sasahara-h/tee-echo-sim/docs/handoff-route1-sensor-nav.md

# 引き継ぎメモ：ルート1（センサーで実物の操作をシミュレータに入れる）以降

作成：2026-10-14　更新：2026-10-15（エンコーダを PEC11D-4120F-S0015 に決定、`.scad` を v2 に改訂）

---

## 1. いまの到達点（作り直さないこと）

- `claude/index.html`（Claude Code で作成済み・手元は `c:/dev/tee-sim`）
  - GPUクリッピング＋Render-to-Texture で断面描画。CPUボクセル方式は廃止済み
  - プローブ4自由度＋左右屈（depth / rot / ante / lr / omni）、標準断面プリセット15種
  - **練習モード＝ナビはすでに実装済み**：一致度メーター（85点で合格）、「次の一手」（例：時計回りに15°回す）、チェックリスト、ASE/SCA 2013・Puchalski 2019 準拠のコース
  - 外部から操作できる窓口がある：`window.TEESIM.setParam(k, v)`（k = depth, rot, ante, lr, omni）、`window.TEESIM.state`
- `claude/hardware/tee_handle.scad`：模型ハンドルの設計図 **v2（PEC11D 対応）**。STLは未書き出し。OpenSCAD で PART を切り替えて F6 → 書き出す

## 2. 先行品の調査結果と立ち位置

- 実物型プローブ付きの商用機：HeartWorks TEE、BabyWorks TEE（新生児・乳児、ASD/VSD等）、CAE Vimedix、MrTEEmothy/eTEEmothy
- Web型：トロント Virtual TEE（標準20断面＋代替19断面、録画動画。自由操作ではない）、CT2TEE（CTベース、自由操作、先天性心疾患2例）、iPhoneアプリ TEE Simulator
- 誘導機能も既存品にある（HeartWorks、TEE Express）。**「シミュレータ単体」「シミュレータ内の誘導」に新規性はない**
- 差別化の候補：
  1. **自前の数理モデルを外部センサー・外部端末とつなげること**（既製品は閉じていて中身を使えない）
  2. 小児の体格・先天性心疾患（特に複雑心奇形、術後形態）
  3. スマートグラスでの術者視界ガイド
- 指導医へは「TEEシミュレータを作った」ではなく、「断面ナビの研究基盤」として、動いている録画を添えて見せる方針

## 3. 実機ガイドへの3ルート

| ルート | 内容 | 必要データ |
|---|---|---|
| **1（いまここ）** | センサーでプローブ状態を直接測り、シミュレータのモデルで目標との差分を計算 | ほぼ不要 |
| 2 | 画像から「今どの標準断面か」だけを分類し、ルート1のずれを補正 | 中程度 |
| 3 | 画像からプローブ位置を推定（シミュレータを教師データ工場に） | 大量。個人では保留 |

カーナビの比喩：センサー＝GPS、シミュレータの心臓モデル＝地図、練習モードの「次の一手」＝「300m先を右」。

### ルート1の弱点（先に言っておくこと）
- 地図（標準モデル）が患者に合っていない → 方向の誘導は使えても「あと15°」の数字は外れうる。最終微調整は術者が画像で
- ダイヤル角＝先端の曲がりとは限らない（食道壁で拘束、シャフトのねじれ）
- 臨床プローブへの取り付けは感染管理・倫理委員会・医療機器の扱いが壁 → **まずはマネキン／模型ハンドルで**

## 4. ハードウェア計画（模型ハンドル）

### 部品
| 物品 | 用途 |
|---|---|
| 二重同軸ロータリーエンコーダ **Bourns PEC11D-4120F-S0015（決定）**、DigiKey 約1,150円。予備含め2個 | 外側＝大ダイヤル（前屈/後屈）、内側＝小ダイヤル（左右屈）。TEEの2連ダイヤルと同じ構造 |
| ユニバーサル基板（2.54mmピッチ、20×33mm に切る） | エンコーダを半田付けし、ハンドル内の柱2本にネジ留め |
| M5StickC Plus2 | マイコン。内蔵IMUで主軸回転も測る（ドリフトが気になれば BNO085 を追加） |
| タクトスイッチ 12mm ×2 | オムニプレーン ＋/− |
| M3タッピングネジ ×4（本体結合）＋ ×2（基板）＋ M3イモネジ ×2（ダイヤル固定） | |
| USB-Cケーブル | PC接続・給電（底の穴から出す） |

挿入深度は当面手入力（シャフト目盛り）。磁気角度センサー AS5600 方式は、同軸エンコーダを使うなら不要。
本物の廃棄プローブは院内（臨床工学技士・メーカー営業）で探す。eBay等の個人購入は薬機法・感染リスクの点で非推奨。

### PEC11D について確定したこと（データシート https://www.bourns.com/data/global/pdfs/PEC11D.pdf ）
- **S（ストローク0.5mm）を選んだ理由**：H（1.5mm）だと、ダイヤルを回す指の力で軸が沈み、ゼロ点リセットの誤作動とダイヤルのぐらつきが増える。プッシュは「長押しでゼロ点」にしてファーム側でも誤作動を防ぐ
- **取付金具なし（Hardware: None）、ブッシュ φ7.0 はネジ山なし** → ナット留めはできない。固定は「壁穴にブッシュ」「受け台で回り止め」「小基板を柱にネジ留め」の3点で行う
- 外軸 φ6.0（スリット入り）、ブッシュ φ7.0、本体 12.0角、軸長は取付面から 20.0
- 30クリック/回転、15パルス/回転 → **1クリック＝ダイヤル12°**。4逓倍で数えると60カウント/回転
- 回転トルク 100±70 gf·cm（φ64ダイヤルなら指先で約30gf＝軽い）、軸の横荷重 2.04kgf以上、回転寿命15,000回
- 実物のTEEダイヤルは滑らか、PEC11Dはクリック感あり（試作では許容）

### クリックの刻みの検証（2026-10-15）
- `index.html` に検証用の「クリック刻みモード」を追加済み（コミット d6a2916。「微調整スライダー・表示設定」の一番下）
- 前屈/後屈の刻みを 28 → 14 → 9° と変えて触った結論：**先端の角度で1クリック14°以下でないと練習にならない**
- 前屈/後屈の全範囲は210°（−90〜120）なので、14°以下にするには**15クリック以上＝ダイヤルが止めから止めまで180°以上回る**必要がある
- 判断基準：大学で実物のダイヤルの回転角を測り、**180°以上なら PEC11D で実物どおりの回転角にできる**。180°未満なら、ダイヤルを実物より多く回す設定にする（録画用には十分）か、2号機を磁気センサー（AS5600 など）にする
- 測るもの：大小ダイヤルの止めから止めまでの角度、ダイヤル90°で先端がどれだけ曲がるか、ダイヤル径、オムニプレーンボタンの動き方、ロックレバー。真上からの動画があると確実

### `.scad` v2 の変更点
- エンコーダ部分だけ壁を 2.0mm に薄くし、φ7.3 のブッシュ穴（取付ネジ前提の φ9.5 を廃止）
- 右半分の内側に **受け台**（12.3角の四角い筒、深さ5mm）と **基板止めの柱2本**（軸から上下12.5mm、M3下穴）を追加
- ダイヤルの厚みと軸穴の深さを、軸長パラメータから自動計算（外軸のかかり 6.2mm、内軸のかかり 7.7mm：仮の値で）
- 小ダイヤルは Dカット穴、止めネジは平面側
- ボタン穴を前面の壁だけに限定（内側の柱・受け台を削らないように）
- **`PART = "fit_test"`** を追加：ブッシュ穴・外軸穴・内軸Dカット穴を余裕 0.1〜0.4mm で並べた試験片。プリンタのクセを先に確かめる
- 組立図に赤い簡易エンコーダと小基板を表示。F5 のコンソールに寸法と警告を echo
- 数値チェック済み：本体背面 X=7.0、基板裏 X=5.4、端子先端 X≈1.9（分割面 X=0 より右＝右半分に全部収まる）。受け台・柱・ボタン穴・ネジボスは互いに非干渉
- **OpenSCAD での描画確認はまだ**（作業環境にインストールできなかった）。手元で F5 → 赤い警告が出ないことを確認

### 実物が届いたらノギスで測る（`.scad` の ★ を上書き）
1. **内軸の直径と、Dカット部の寸法**（INNER_SHAFT_D / INNER_D_ACROSS）：データシートの読み取りで φ3.5・2.5 としたが最も不確か
2. **外軸の先端までの長さ**（OUTER_SHAFT_END）：取付面から。候補 10.0 / 11.7 / 13.1
3. 本体の奥行き（ENC_BODY_DEPTH、仮 8.0）とブッシュ長（BUSH_LEN、仮 5.0）
4. 端子が背面から出る長さ（基板の厚みと合わせて分割面を越えないか）

## 4b. 方針変更（2026-10-16）：滑らかなダイヤル＝ポテンショメータ＋歯車方式で行く

PEC11D（クリック式）は**保留（購入しない）**。理由：滑らかさ・回しきりの止め・電源投入時に角度が分かること・1°未満の細かさ・マイコンのピン不足の解消を優先。

### 構造
- 同軸の軸：入れ子になる真鍮パイプ（外側＝外径6mm、内側＝外径5mmのパイプか丸棒。K&S のメートル系真鍮パイプは肉厚0.45mmで入れ子になる設計）。外側に大ダイヤル（前屈/後屈）、内側に小ダイヤル（左右屈）
- 各軸に3Dプリントの歯車 → ハンドル内に横並びの**クリックなしポテンショメータ（B10KΩ＝直線、約300°で止め付き）2個**を回す。同軸の問題は歯車で横にずらして解決
- 軸受けは当面プリントのブッシュ。Oリングで回転に適度な重さ（手を離しても止まる）
- 歯車比は、大学で測る実物ダイヤルの回転角で決める（実物の全回転角 → ポテンショメータの約300°の内側に収める）
- M5StickC Plus2 のピン：ポテンショメータは ADC1 の G32・G33（Grove 端子）、ボタンは G26・G36 など。ゼロ点合わせは不要（絶対角）。両端に回しきったときの値を一度記録するキャリブレーションだけ

### 次の作業
1. ポテンショメータ数種と真鍮パイプを買って、手で回した感触と入れ子のはまり具合を確かめる
2. 実物の寸法（ポテンショメータの本体径・軸径・軸長・取付ネジ、パイプの実寸）を測る
3. `.scad` v3 を作る：同軸シャフトの軸受け、歯車2組、ポテンショメータの取付台（M7ナットで留める）、ボタン位置の見直し

### 購入状況（2026-10-17 注文）
- 秋月：小型ボリューム 10KΩB（118292）×4、ユニバーサル基板 Cタイプ ×2、タクトスイッチ 12mm 黒・グレー 各2、コネクター付ケーブル 40P オスメス、みの虫クリップ付きコード ×2、ピンヘッダ 1×40
- Amazon：M5StickC PLUS2、USB A–C ケーブル 1m×2、タッピングねじ 3×8（2種 B0形）、イモネジ M3×3、TONE 六角レンチ 1.5mm ×2、Oリング（benrii 18種）、M3 六角ナット（5.5×2.4）、K&S アルミパイプ 外径6/内径5.1（KS9805）、K&S 真鍮パイプ 外径5/内径4.1、WORKPRO パイプカッター、ステンレス デジタルノギス
- 半田ごては保留（ものづくり施設で借りられるか確認中）。PEC11D は買わない

### `.scad` v3 試作ブロック（`claude/hardware/tee_handle_v3_testblock.scad`、下書き）
- ダイヤル・同軸パイプ・歯車・ボリューム2個だけの手のひらサイズ。枠（前板＋筒、ボリューム板A/B、側板）
- ボリュームAは軸の上（+Z、中心距離16.15）、Bは下（-Z、14.15）。どちらも本体が奥、軸先が前板を向く。軸先に小歯車を圧入
- 歯車 m=1、A 16:16、B 14:14（比率1）。歯車A/Bはパイプに圧入、ダイヤルは M3 ナット埋め込み＋イモネジ
- 大ダイヤルの重さは前板の溝の Oリング（5×2）で調整
- パイプを切る長さ（初期値）：外側23.8mm、内側39.6mm。前板外面からボリュームB背面まで43.1mm → ハンドル組込み時は頭部を広げるか、ボリュームの軸を切って短くする
- 寸法の干渉チェックは Python で全項目 OK。OpenSCAD での描画確認はまだ（作業環境に入らない）
- ★の仮の値：ボリュームの本体厚・ネジ部の径と長さ・軸長・ナット寸法、歯車の圧入値、実物ダイヤルの回転角

### ファームウェアの準備（2026-10-17）
- `firmware/`（PlatformIO、Arduino、M5Unified 0.2.26 / M5GFX 0.2.33 / espressif32 7.1.3 に固定、env名 m5stickc_plus2）。画面に「Hello」を出すだけの最小版。ビルド SUCCESS、コミット済み（4872439）
- VS Code に PlatformIO IDE 拡張を導入済み。`firmware` フォルダを開くと下のバーに ✓（ビルド）→（書き込み）コンセント（シリアルモニター）が出る
- 今の main.cpp は PC に何も送らない（シリアルモニターは空のまま。画面に Hello が出れば成功）
- 実機が届いたら → で書き込み。ポートが見つからなければ CH9102 ドライバ
- fit_test の STL は書き出し済み（hardware/ に tee_handle_v3_testblock.stl として保存。PART が fit_test だったか要確認、fit_test.stl に改名予定）

### 実機TEEダイヤルの実測（2026-10-20、大学、**Philips X8-2t**（xMATRIX 成人用 3D TEE）。写真から読み取り、誤差 ±10°程度）
- 大ダイヤル（前屈/後屈、奥・薄い灰色・羽根6枚）：まっすぐ＝目印9時。**前屈いっぱい 約95°（時計回り）／後屈いっぱい 約60°（反時計回り）／全体 約155°**。まっすぐの位置は前屈側に寄っている（非対称）
- 小ダイヤル（左右屈、手前・濃い灰色）：まっすぐ＝9時（ダイヤルに細い線の目印あり）。**右屈 約50°／左屈 約55°／全体 約105°**、ほぼ対称
- まっすぐのとき大小とも9時方向がそろう作り。小ダイヤル表面に R/L の矢印印刷（矢印の先の印は止めの位置ではない）
- オムニプレーンのボタン：ダイヤルが出ている面から90°回った面（ダイヤルとほぼ同じ高さ）に、縦長の黒いゴムのパネル。**丸ボタン（上）・楕円ボタン（中）・丸ボタン（下）の3つ**。上下が ＋/−。**中央の楕円は押せない（ボタンではない。指で上下を区別する目印と思われる）**。模型でも中央に押せない出っ張りを付けると手触りが近づく。v2 の配置（ダイヤル＝+X 側面、ボタン＝前面）と同じ関係
- ダイヤル直下にレバー（ロックレバーと思われる）
- 設計への反映：DIAL_TRAVEL_A=155、DIAL_TRAVEL_B=105。歯車比はボリューム300°の内側に収まるよう上げる（A 約1.7、B 約2.5 が目安）。ダイヤルに機械的な止めを付けて、実物と同じ回転角で止まるようにする

### 持ち方（2026-10-21 ユーザー提示、こちらが正。先に見せた成書の図は古い情報として破棄）
- 左手で操作部、右手でシャフトの両手操作が標準。観察中は持ち替えない
- 左手：**親指＝大ダイヤル（前屈/後屈）**、**人差し指・中指＝小ダイヤル（左右屈）**、**薬指・小指＝グリップを握って支える**、空いた指でロックレバー・オムニプレーンのボタン等
- 右手：口元近くでシャフトを持ち、**挿入・引き抜き**と**シャフトをひねる主軸回転**
- **実際の臨床（ユーザーの経験）**：指の担当は固定ではなく、大ダイヤル・小ダイヤル・オムニボタンを**親指・人差し指・中指のうち空いている指で**操作している。薬指・小指は握って支える
- 設計への反映：
  - **最重要：大ダイヤル・小ダイヤル・オムニボタンの3つすべてが、握ったまま親指・人差し指・中指のどれからも届く範囲にまとまっていること**（指の担当を決め打ちしない）
  - グリップは薬指・小指で支えられる太さ・長さ。持ち替え不要な配置
  - 大ダイヤルは親指が自然に掛かる位置、小ダイヤルは人差し指・中指が届く位置（実機は同軸で小が手前）
  - 主軸回転は右手でシャフトをひねる → ハンドルも一緒に回るので、ハンドル内 IMU で測る方針は変わらない
  - 挿入深度も右手がシャフトで行う → 模型にもシャフト（チューブ）を付ける価値が高い。深度センサーを足すときはシャフト側（糸巻き式など）
- **口とシャフトはコントローラー完成後に作る**（順番：試作ブロック → ハンドル本体 → シミュレータ連動 → 録画 → 口とシャフト）。そのための今からの準備：
  - ハンドル本体の先端側に、シャフト（チューブ）を差し込む穴を最初から設ける（大きめにして、チューブ決定後に変換部品で合わせる）
  - M5StickC Plus2 の ADC1 ピン3本（G32・G33・G36）のうち、G32・G33 をダイヤル2つ、**G36 を挿入深度用に予約**
  - 口の部品（シャフトが通る筒、机に固定、深度センサーをここに付ける）は別部品なのでいつでも作れる

### 挿入深度・主軸回転（あとで考える）
- 挿入深度は当面センサーなし（シミュレータのスライダー／キー）。後で足すなら、予備のボリュームに糸巻きを付けてシャフトに糸を結ぶ方式が最も手軽。ほかに距離センサー
- 主軸回転は M5StickC 内蔵 IMU（MPU6886、地磁気なし）のジャイロ頼み → ドリフトする。ボタンでゼロ点合わせ、気になれば BNO085 を追加

## 5. 次にやること（順番）※1番は 4b の方式に置き換え

1. ~~エンコーダの選定~~（済：PEC11D-4120F-S0015）／~~.scad の PEC11D 対応~~（済：v2、仮寸法）
   → **残り**：購入 → 実寸を測って ★ を上書き → fit_test を印刷して余裕を決定 → 右半分・ダイヤルを書き出し → 3Dプリント（院内・大学・自治体のものづくり施設）
2. M5StickC Plus2 のファームウェア（Arduino）：エンコーダ2軸のカウント（4逓倍）、ボタン2つ＋軸プッシュ（長押しでゼロ点）、IMUのヨー角を読み、一定周期でシリアル送信
3. `index.html` に **Web Serial** 入力を追加し、受け取った値を `TEESIM.setParam` に流す
   - ゼロ点合わせ（キャリブレーション）ボタン、カウント→角度の換算係数を設定可能に（初期値：1クリック＝12° のダイヤル回転に対し、先端角を何度とみなすか）
   - 既存の範囲：ante −90〜120、lr −45〜45、rot −180〜180、omni 0〜180
4. 実物のダイヤルを回すと断面と練習モードのナビが連動する様子を録画 → 指導医へ
5. 練習モードの「次の一手」を別端末（スマホ → Even G2 スマートグラス）に表示
6. 小児サイズ：まず相似縮小（角度は不変、挿入深度だけ縮む）。小児らしい形態は ImageCHD / HVSMR-2.0 / NIH 3D Print Exchange のモデルが必要（弁なし・食道位置・座標系統一・ライセンスに注意）
