sasahara-h/tee-echo-sim/(commit log)

2026-10-13 TEEプリセットに4断面を追加（MV Comm, RV In-Out, AsAo LAX, TG 2Ch）
2026-10-13 大血管系に大動脈弓・胸部下行大動脈・左右肺動脈を追加
    - build_heart.py: FJ3411 (Arch), FJ1931 (DAo), FJ3019 (RPA), FJ2924 (LPA) を追加
    - bodyparts3d.js を再生成
    - index.html: classify() で新パーツを vessel として扱う
2026-10-13 食道経路を下行大動脈の右側に引き直し、AsAo SAX・Desc Ao SAX/LAX を追加（全13プリセット再計算）
2026-10-13 AsAo LAX・TG mid SAX・TG 2Ch をASEガイドラインの角度範囲に合わせて修正
2026-10-13 大動脈弁の左冠尖と無冠尖のFJ番号の対応を修正
    FMA の left posterior cusp (FJ2426) が左冠尖、right posterior cusp (FJ2431) が無冠尖。
    build_heart.py の対応を入れ替え、bodyparts3d.js を再生成。
2026-10-13 PV弁尖を主肺動脈起始部へ寄せる fixPV 補正を追加
2026-10-13 練習モードを追加（目標断面への操作ガイド・一致度判定・ヒント）
    - 目標断面（13プリセット or ランダム）を選んで開始、一致度 85 以上で合格
    - 深度・回転・オムニ角・前後屈・左右屈の順に次の一手を表示
    - ヒントに ASE/SCA 2013 準拠の操作のコツと見えるべき構造
    - 練習中はオーバーレイの近い標準断面表示を隠す
2026-10-13 練習モードをベース断面→派生のコース形式に変更、UE大動脈弓 LAX/SAX を追加
2026-10-13 CLAUDE.md を追加（目的・座標系・数値の扱い・作業ルール）
2026-10-13 source/ の生成ファイルを .gitignore に追加
2026-10-13 左パネルに BodyParts3D のクレジットと教育用の注意書きを追加
2026-10-13 クレジットを左パネル最下部の1行に簡略化し、教育用の注意書きを削除
2026-10-14 練習モードの手順を「今からの量＋目標の絶対値」に統一し、合格後は模範との差を参考表示に
2026-10-14 .gitignore に *.zip を追加
2026-10-15 検証用の「クリック刻みモード」を追加（ante/lr の手動操作を刻み幅の倍数に丸める）
    スライダー・キー・ホイール・大小ダイヤルのドラッグが対象。プリセットと練習モードの移動は丸めない。
2026-10-15 TEE プローブ模型ハンドルの OpenSCAD ファイルを追加、.gitignore に *.stl を追加
    [tee_handle.scad]
2026-10-17 TEE プローブ模型ハンドル v3 の試作ブロック（ボリューム＋歯車方式のダイヤル部）を追加
    [tee_handle_v3_testblock.scad]
2026-10-17 v3 試作ブロックに組立図の断面表示（CUTAWAY）を追加
    [tee_handle_v3_testblock.scad]
2026-10-17 M5StickC Plus2 用ファームウェアの最小プロジェクトを追加（PlatformIO、画面に Hello を表示）
2026-10-18 練習モードのパネルをエコー画面左上の半透明フローティングカードに移す
    - 未開始時は「練習モード ▶」の小ボタンのみ表示し、押すと断面選択つきカードを開く
    - カード幅はエコー画面幅の35%（200〜320px）、高さが足りないときはカード内スクロール
    - ヘッダーの「−」で畳むと「目標名＋次の一手」の1行だけになる
    - 背景・内側要素を半透明にして、扇形に重なってもエコー像が透けて見える
2026-10-18 3Dビューとエコー画面の幅を 4:6 にし、境目をドラッグで動かせるようにする
    - 初期比率は 4:6（保存はせず、開くたびに 4:6 に戻る）
    - 境目ドラッグで比率を変更（3D 側 20〜80% に制限）。狭い画面の縦並びレイアウトでは非表示
    - 3D ビューが狭くなっても見出しがボタンに重ならないよう省略表示にする
2026-10-18 練習カードの目標名の下を「断面の目的」1文に変える
    - PRACTICE_INFO に各断面の purpose を追加し、目標名の下に表示
    - 操作方法（how）はヒントの「操作のコツ」にだけ出す
2026-10-18 ME 4Ch のヒント「操作のコツ」から目的文と重複する一文を削る
2026-10-18 練習カードの置き場所を画面幅で切り替える
    - 980px以下（縦並びレイアウト）では左パネルの読み取り値の下に普通のパネルとして表示
    - 広い画面では従来どおりエコー左上のフローティング
    - 同じ DOM を移動するので、中身・ボタン・畳む状態は両方で共通
2026-10-18 スマホ表示を1画面レイアウトに戻し、Retina端末で断面が崩れるバグを直す
    - renderSection / renderEcho で RenderTarget 描画時の setViewport を削除
    （three.js が devicePixelRatio を掛けるため、DPR 2〜3 の端末で断面が拡大・欠落していた）
    - 980px以下：縦持ちは上段エコー／下段左3D・右ハンドル、横持ちは ハンドル｜エコー｜3D。ページはスクロールしない
    - ヘッダーはプリセット1行の横スクロール＋「⚙ 詳細」ボタン。読み取り値・設定・説明・クレジットを #panelExtra にまとめ、下からのシートで開閉
    - 練習カードはスマホでは詳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
2026-10-18 スマホをコントローラーにして PC と連動させる「連動モード」を追加
    - ヘッダー右端「📱 スマホで操作」で QR コードとコントローラー用 URL を表示（localhost のときは IP で開き直す案内）
    - 連動中の PC はハンドルパネルを隠して 3D＋エコーを全幅表示。「連動中 ●」「通常モードに戻す」
    切断（ハートビート 5 秒途絶）または戻すボタンで通常レイアウトへ。プローブ位置は引き継ぐ
    - スマホ側（?controller=部屋ID）はプリセット1行＋ハンドルだけ。3D・エコーは描画しない
    値の変化を最大30回/秒で送信、プリセッ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
2026-10-18 コントローラー画面（?controller=）でダイヤルが表示されないのを直す
    - 原因：グリッド列が 1fr だったため、横スクロールのプリセット列（約1570px）の幅まで広がり、
    SVG がその中央＝画面外にダイヤルを描いていた。列を minmax(0,1fr) にする
    - あわせて #handleSvg を #handlePanel に絶対配置して枠いっぱいに置く（flex 内の SVG に頼らない。iPhone Safari 対策）
2026-10-18 3Dビューに「ホログラム表示」モードを追加（表示設定のチェックボックス、初期値 OFF）
    - ON：心臓・血管とゴーストを加算合成のフレネル（リムライト）シェーダーに差し替え、背景を暗く
    水色〜シアン、弁は明るめ。横の細い走査線がゆっくり流れ、わずかにちらつき、明るさだけゆっくり脈打つ
    - OFF：元のマテリアル・背景オブジェクトに戻すので見た目は完全に元どおり
    - プローブ・扇は変更なし。2Dエコー（別シーンで描画）と練習モードには影響しない
    - 処理は「4d. ホログラム表示」ブロック（makeHoloMat /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
2026-10-18 スマホ表示のヘッダーに「📱 スマホで操作」が出てしまうのを直す
    非表示ルールが .linkUI の基本ルールより前にあって上書きされていた。基本ルールの後ろに移す
2026-10-18 PC のヘッダーを低くし、「📱 スマホで操作」をプリセットと同じ行に置く
    プリセット列が1行分の幅（約1570px）で場所を取り、ボタンが3行目に押し出されていた。
    プリセット列を flex:1 1 0 にしてタイトル・ボタンと同じ行で折り返すようにする（1528px 幅で 140px → 71px）
2026-10-18 Revert "PC のヘッダーを低くし、「📱 スマホで操作」をプリセットと同じ行に置く"
    This reverts commit a140a93e7bc85b91fbd2bac5632823f4f0e7f704.
2026-10-18 Revert "3Dビューに「ホログラム表示」モードを追加（表示設定のチェックボックス、初期値 OFF）"
    This reverts commit e5e1657736ca5a03ef5e1f9a9c31ced3e687af09.
2026-10-19 GitHub Pages のビルドをやり直すための空コミット
2026-10-19 CLAUDE.md に公開URL（GitHub Pages）と更新方法を追記
2026-10-21 ルート1（センサー連動・模型ハンドル）の引き継ぎメモを docs/ に追加
2026-10-21 CLAUDE.md にハードウェアの引き継ぎメモへの案内を追記
2026-10-23 連動モードの接続を速く・確実にする（段階表示、TURN 中継、自動やり直し、コントローラーの軽量化）
    - スマホ側コントローラーでは Three.js と bodyparts3d.js（約2MB）を読み込まず、メッシュも WebGL も作らない
    - 接続の段階をスマホと PC に表示（仲介サーバーに接続中 → PC を探しています → 接続中 → 直接／中継）
    - Metered の TURN を追加。PC が見つかってから 3 秒直接つながらなければ中継だけで接続し直す
    - 10 秒つながらなければ最初からやり直す（PeerJS の仲介サーバーは 2 回目以降の接続に peer-unavailable を返さな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
2026-10-23 CLAUDE.md に TURN 認証情報をコミットしている例外を追記
